louiscklaw/stm32_aux_keyboard/_ref/2019-06-02-14-12-keeb.io.png

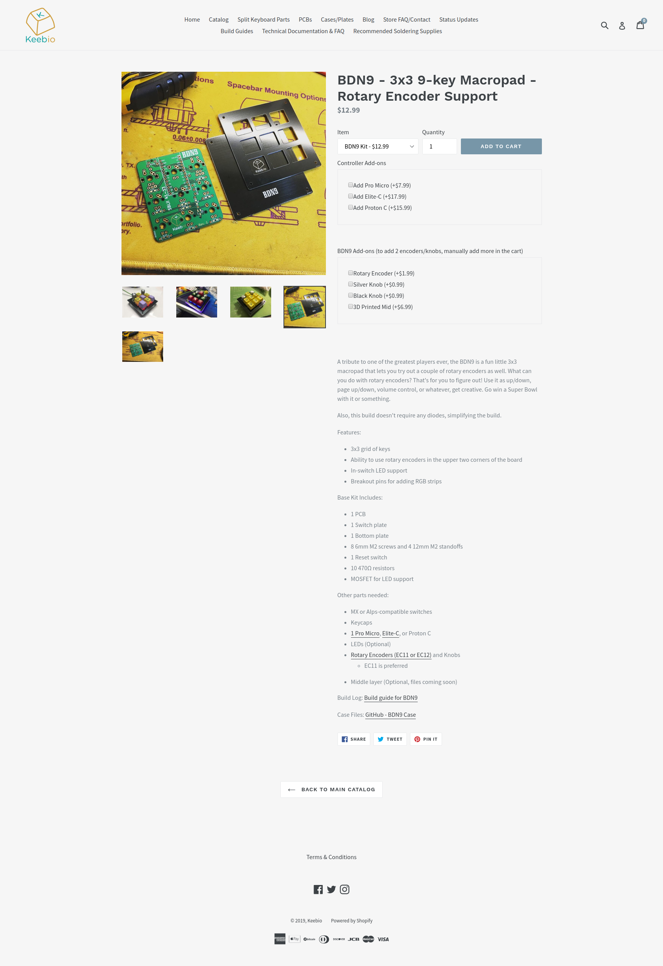
_ref/2019-06-02-14-12-keeb.io.png
