louiscklaw/stm32_aux_keyboard/_ref/TB24ozynljTBKNjSZFDXXbVgVXa_!!2891423389.jpg

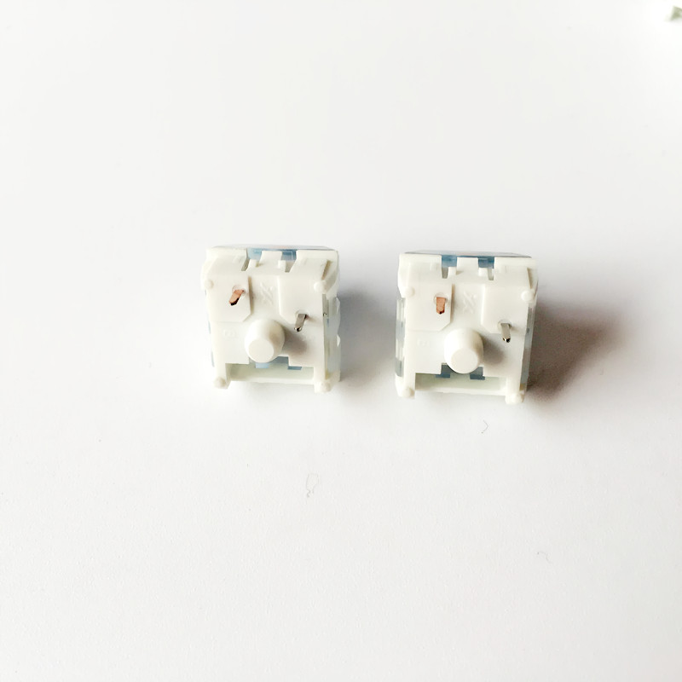
_ref/TB24ozynljTBKNjSZFDXXbVgVXa_!!2891423389.jpg
