louiscklaw/stm32_aux_keyboard/datasheet/MLT-8530.jpg

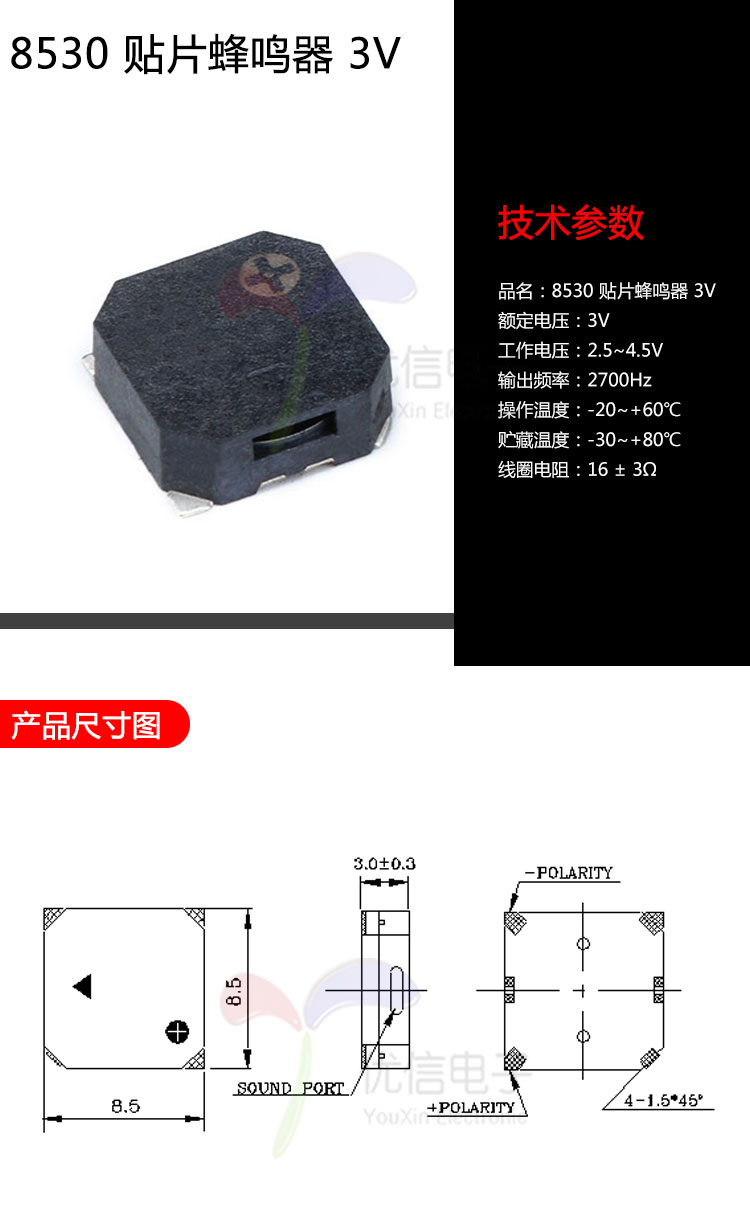
datasheet/MLT-8530.jpg
