louiscklaw/stm32_aux_keyboard/_models/crkbd-master/corne-classic/acrylic_plate/tilting-tenting.dxf

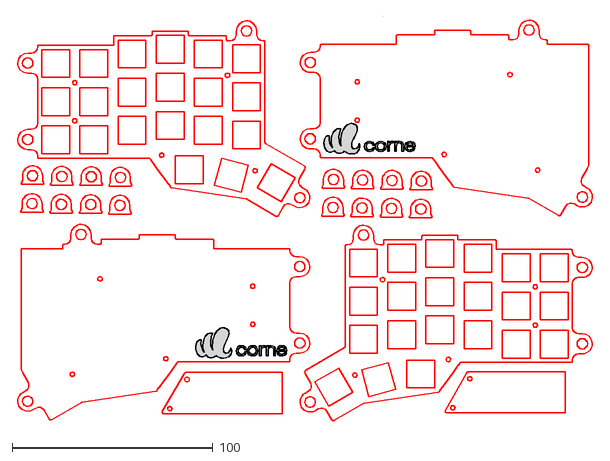
[picture p4: CAD file, 2019-06-02]
_models/crkbd-master/corne-classic/acrylic_plate/tilting-tenting.dxf
287.5 x 201.4
