louiscklaw/stm32_aux_keyboard/_models/crkbd-master/corne-jian/caps/corne-cap.FCStd

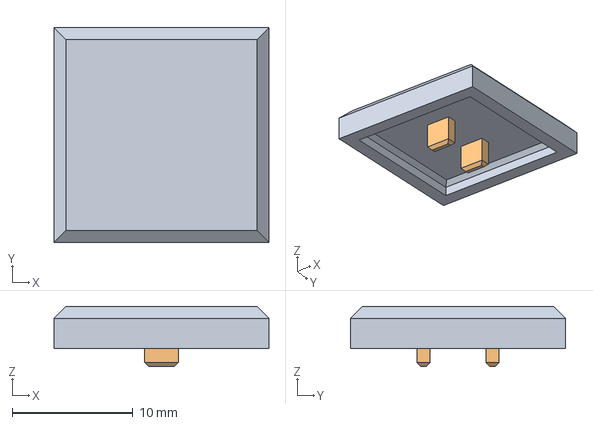
[picture p5: CAD file, 2019-06-02]
_models/crkbd-master/corne-jian/caps/corne-cap.FCStd
17.8 x 17.8 x 5.00 mm
