louiscklaw/stm32_aux_keyboard/_models/crkbd-master/corne-jian/case/corne-case-mirror.stl

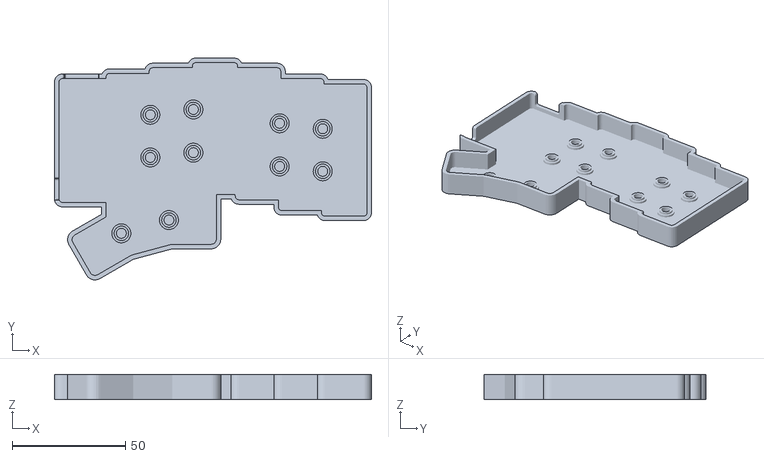
[picture p6: CAD file, 2019-06-02]
_models/crkbd-master/corne-jian/case/corne-case-mirror.stl
139.8 x 97.8 x 11.1
