louiscklaw/stm32_aux_keyboard/_models/crkbd-master/corne-jian/pcb/3d-models/kailh-choc-switch-cap-custom.step

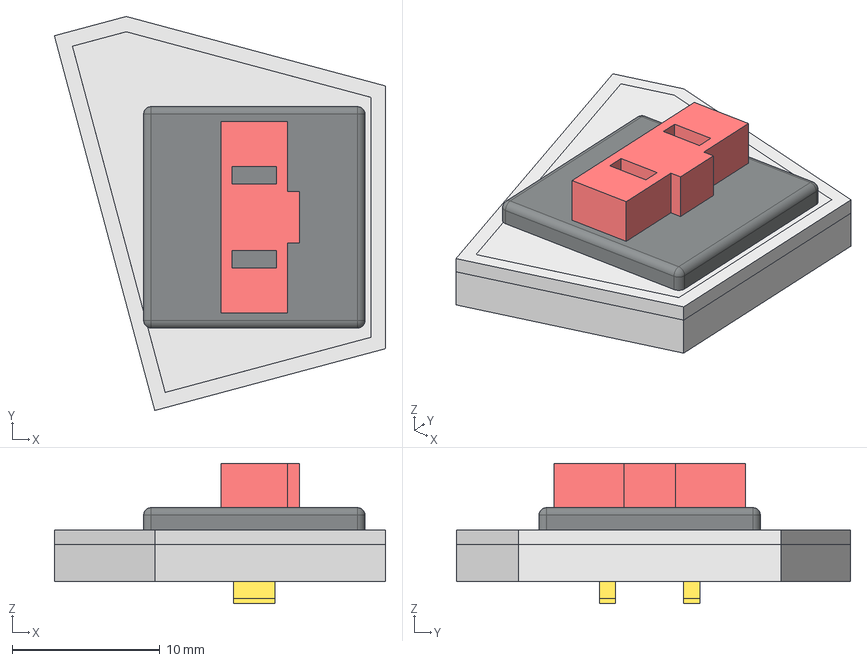
[picture p7: CAD file, 2019-06-02]
_models/crkbd-master/corne-jian/pcb/3d-models/kailh-choc-switch-cap-custom.step
22.5 x 26.7 x 9.50 mm
ShapeBinder001 x 2
Offset2D
Sketch005
