louiscklaw/stm32_aux_keyboard/casing/Extrude.step

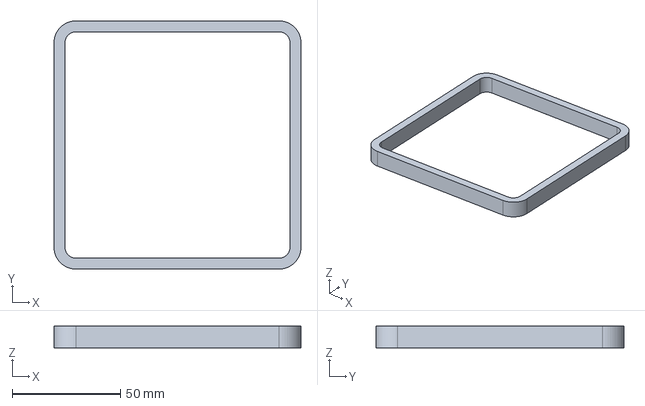
[picture p9: CAD file, 2019-06-04]
casing/Extrude.step
114.2 x 114.8 x 10.0 mm
