louiscklaw/stm32_aux_keyboard/_models/crkbd-master/corne-classic/acrylic_plate/top-bottom.dxf

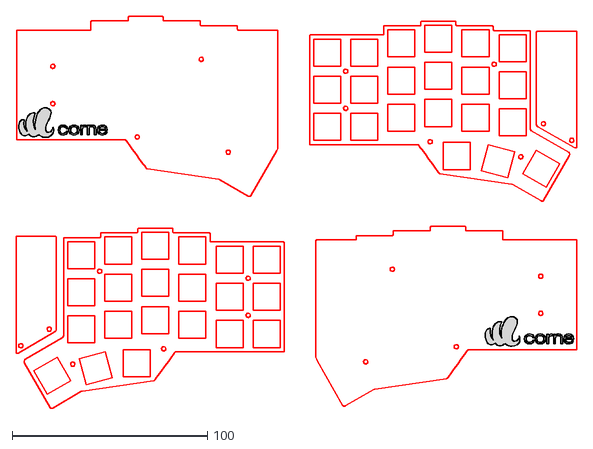
[picture p10: CAD file, 2019-06-02]
_models/crkbd-master/corne-classic/acrylic_plate/top-bottom.dxf
287.2 x 200.8
