louiscklaw/stm32_aux_keyboard/_models/crkbd-master/corne-jian/caps/corne-cap-custom-mirror.stl

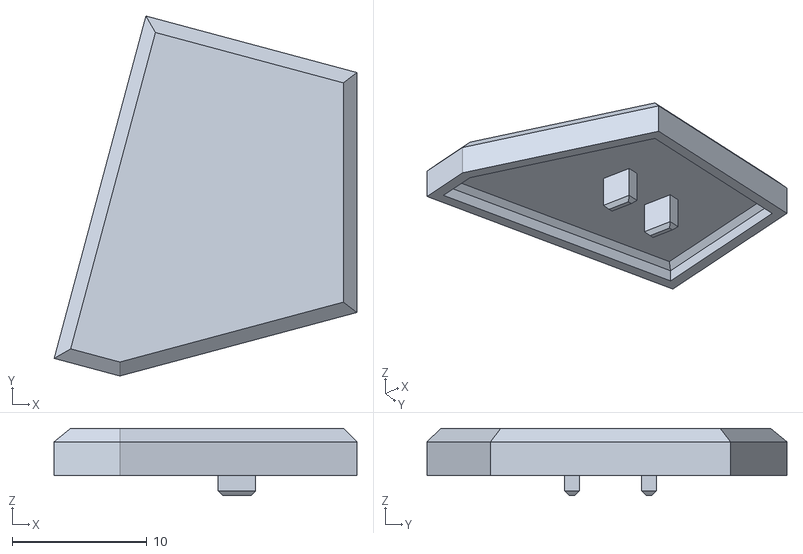
[picture p11: CAD file, 2019-06-02]
_models/crkbd-master/corne-jian/caps/corne-cap-custom-mirror.stl
22.5 x 26.7 x 5.00
