louiscklaw/stm32_aux_keyboard/_models/crkbd-master/corne-jian/pcb/3d-models/kailh-choc-switch.step

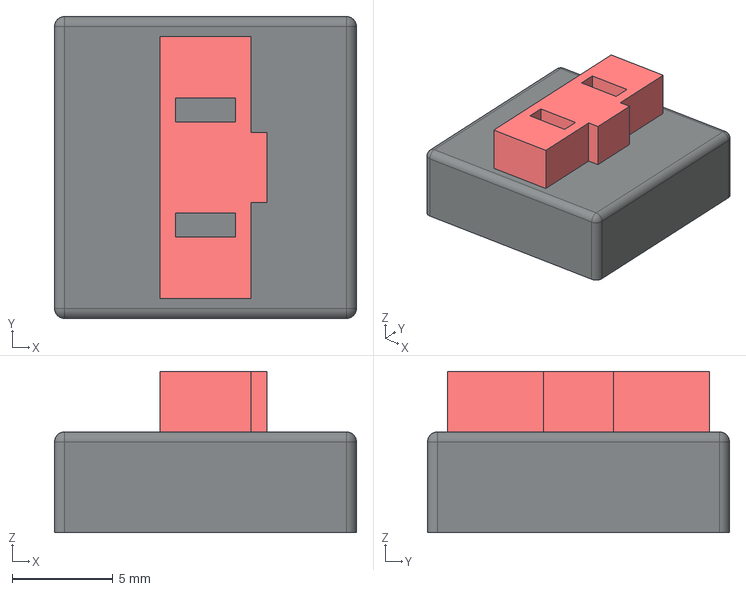
[picture p12: CAD file, 2019-06-02]
_models/crkbd-master/corne-jian/pcb/3d-models/kailh-choc-switch.step
15.0 x 15.0 x 8.00 mm
Stem
