louiscklaw/stm32_aux_keyboard/_models/MX 轴标准键帽.STEP

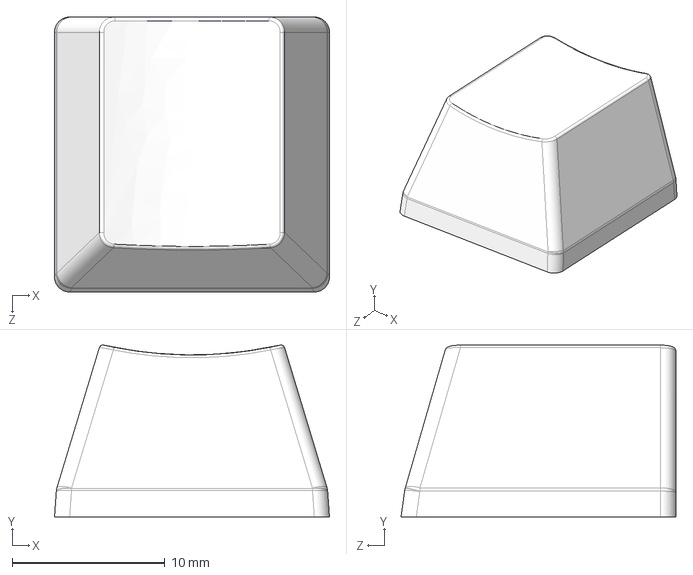
[picture p13: CAD file, 2019-06-02]
_models/MX 轴标准键帽.STEP
18.0 x 11.3 x 18.0 mm
