louiscklaw/stm32_aux_keyboard/_models/crkbd-master/corne-jian/pcb/3d-models/kailh-choc-switch-cap.step

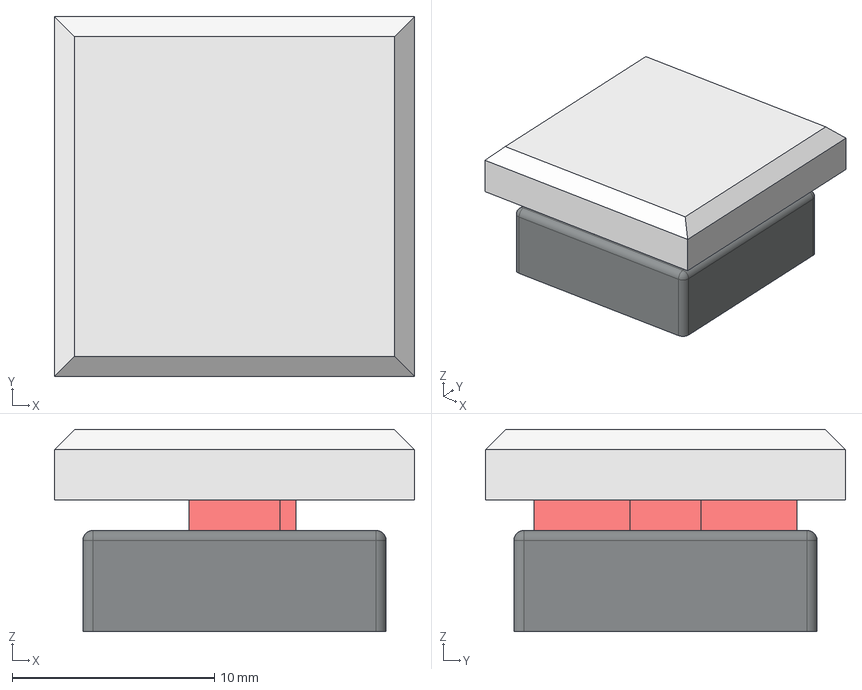
[picture p14: CAD file, 2019-06-02]
_models/crkbd-master/corne-jian/pcb/3d-models/kailh-choc-switch-cap.step
17.8 x 17.8 x 10.0 mm
Stem
ShapeBinder x 2
