louiscklaw/stm32_aux_keyboard/(list of files, cad)

Other CAD files:
_models/crkbd-master/corne-jian/case/corne-case.stl
casing/Cube.step
_models/crkbd-master/corne-jian/caps/corne-cap-custom.stl
casing/casing.FCStd
_models/crkbd-master/corne-jian/caps/corne-cap.stl
