louiscklaw/stm32_aux_keyboard/(list of files, drawings)

Other design files:
hardware/buzzer.dsn
hardware/keyboard_key.dsn
hardware/oled.dsn
hardware/power.dsn
hardware/rot_enc2.dsn
hardware/rot_enc.dsn
hardware/stm32_aux_keyboard.dsn
hardware/stm32_core.dsn
hardware/stm32_swd.dsn
