louiscklaw/stm32_aux_keyboard/hardware/stm32_aux_keyboard.kicad_pcb

## KiCad design hardware/stm32_aux_keyboard.kicad_pcb (2019-06-06)

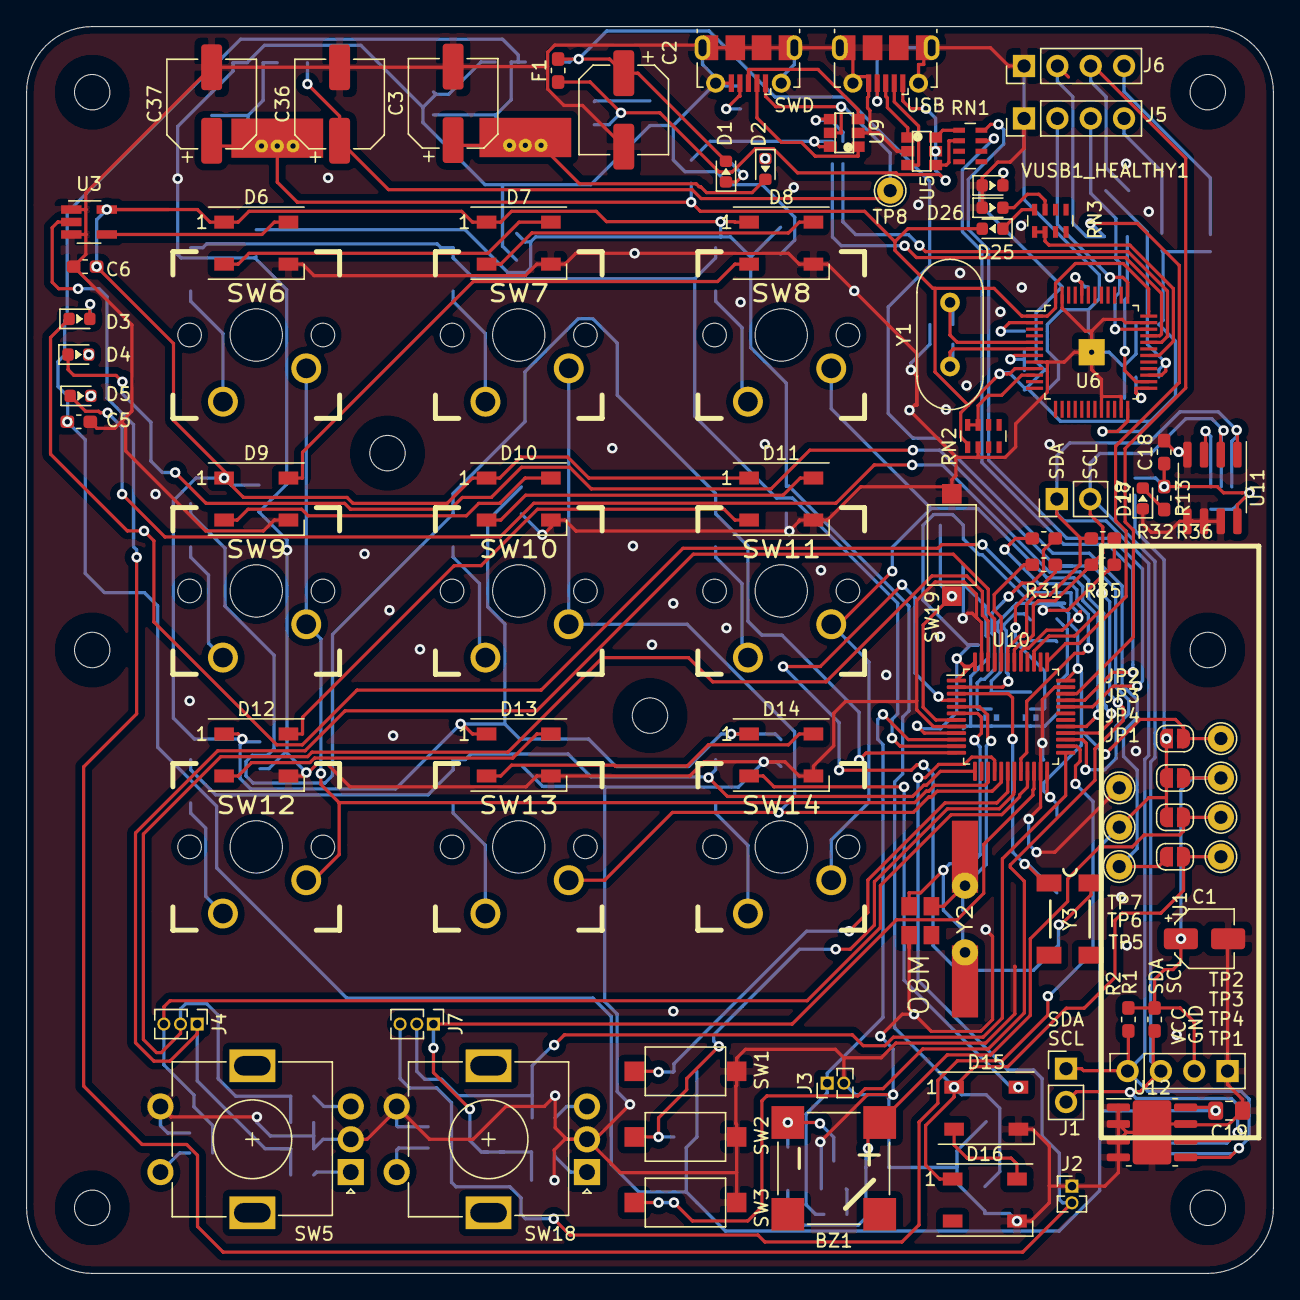
[picture p15: board stm32_aux_keyboard.kicad_pcb from above]

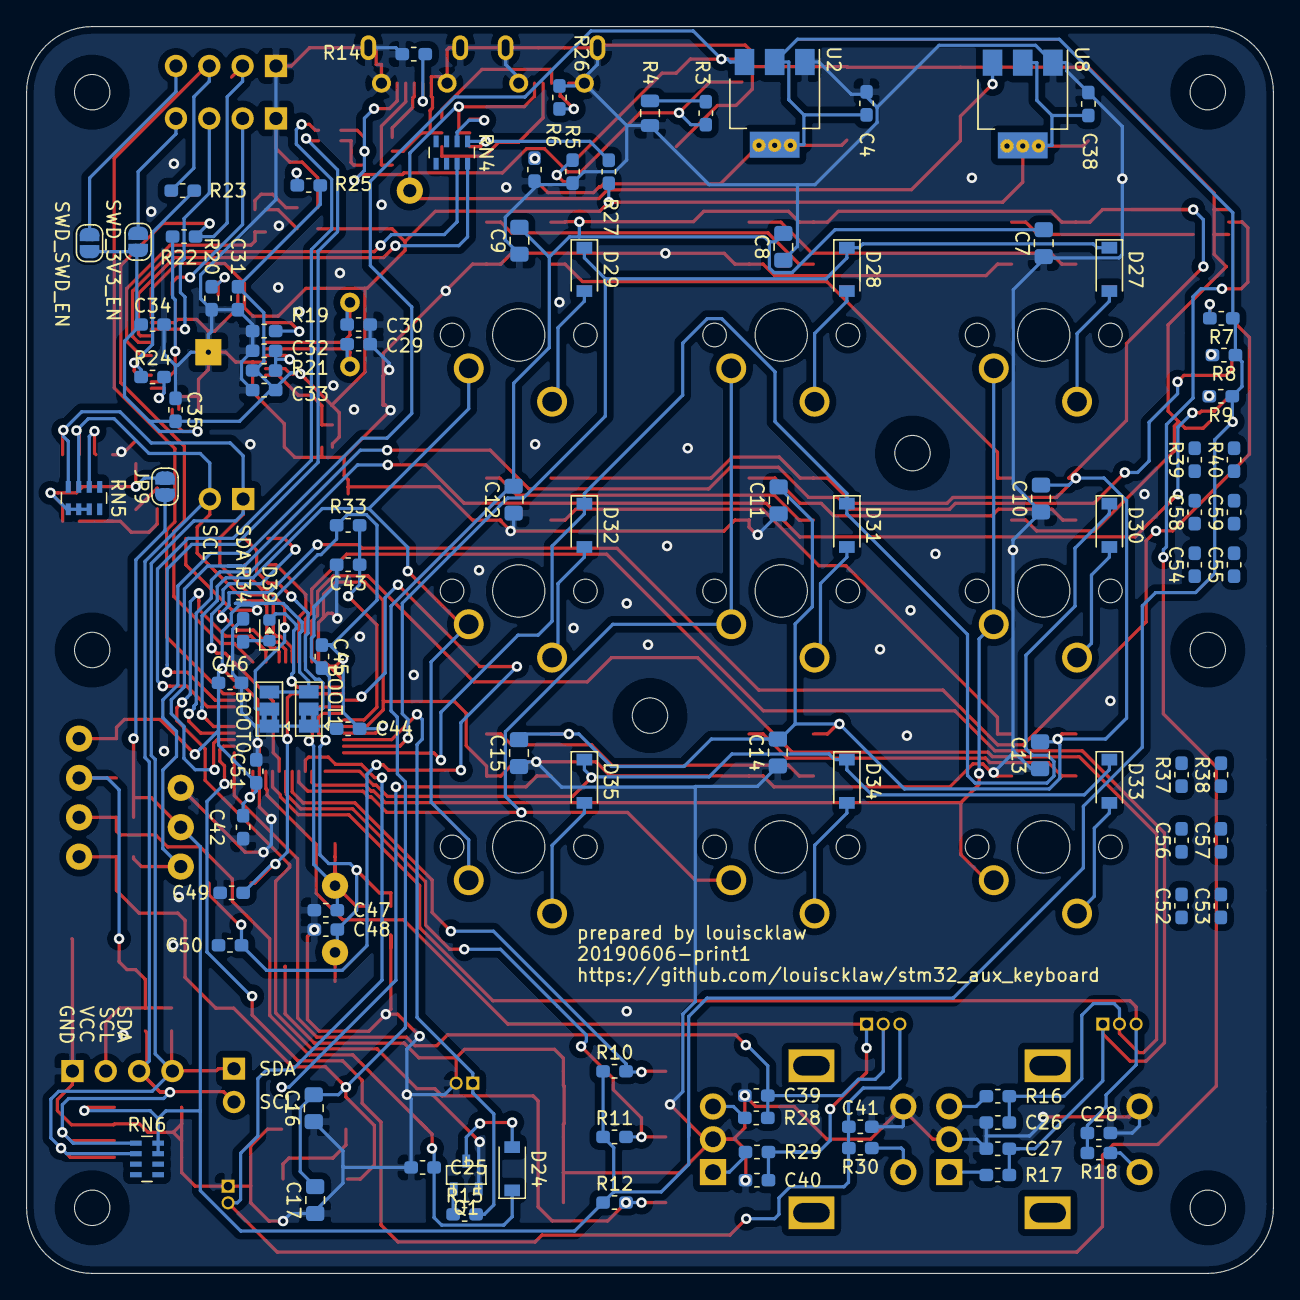
[picture p16: board stm32_aux_keyboard.kicad_pcb from below]

Board: 2 copper layers, 95.0 x 95.0 mm, 197 parts (100 on the bottom side), 113 nets.

Parts:
BZ1: BUZZER,MLT-8530; MLT-8530
C1: CP10uf,16V; CP_Elec_4x5.3
C2, C3, C36, C37: CP100uf,16V; CP_Elec_6.3x5.3
C4, C38: C105; C_0603_1608Metric_Pad1.05x0.95mm_HandSolder
C5, C6, C25: C106,0603; C_0603_1608Metric_Pad1.05x0.95mm_HandSolder
C7, C8, C9, C10, C11, C12, C13, C14, C15, C16, C17, C19: C106,0805; C_0805_2012Metric_Pad1.15x1.40mm_HandSolder
C18: C103,0603; C_0603_1608Metric_Pad1.05x0.95mm_HandSolder
C26, C27, C28, C31, C32, C33, C34, C35, C39, C40, C41, C42, C44, C45, C46, C51: C104,0603; C_0603_1608Metric_Pad1.05x0.95mm_HandSolder
C29, C30: C20pf,0603; C_0603_1608Metric_Pad1.05x0.95mm_HandSolder
C43: C105,0603; C_0603_1608Metric_Pad1.05x0.95mm_HandSolder
C47, C48, C49, C50: C20pf; C_0603_1608Metric_Pad1.05x0.95mm_HandSolder
C52, C53, C54, C55, C56, C57, C58, C59: SPARE,0603; C_0603_1608Metric_Pad1.05x0.95mm_HandSolder
D1: LED_GREEN; LED_0603_1608Metric
D2: LED_ORANGE; LED_0603_1608Metric
D3: USR_LED_1; LED_0603_1608Metric
D4: USR_LED_2; LED_0603_1608Metric
D5: USR_LED_3; LED_0603_1608Metric
D6, D7, D8, D9, D10, D11, D12, D13, D14, D15, D16: WS2812B; LED_WS2812B_5050_white
D17, D25: LED_GREEN,0603; LED_0603_1608Metric
D24, D27, D28, D29, D30, D31, D32, D33, D34, D35: D_1N4148_T4; D_SOD-123
D26: LED_RED,0603; LED_0603_1608Metric
D39: PC13; LED_0603_1608Metric
F1: Fuse_Small; R_0603_1608Metric_Pad1.05x0.95mm_HandSolder
H1, H2, H3, H4, H5, H6, H7, H8: MOUNT_M2; MountingHole_2.7mm_M2.5,rpi_like
J1, J8: I2C_HEADER,2.54; I2C_DEBUG,2.54
J2: WS2812_HEADER; PinHeader_1x02_P1.27mm_Vertical
J3: BUZZER_HEADER; PinHeader_1x02_P1.27mm_Vertical
J4, J7: ROT_ENC_HEADER; PinHeader_1x03_P1.27mm_Vertical
J5, J6: SWD_SWD; BLUEPILL_SWD
JP1: WS2812_EN; SolderJumper-2_P1.3mm_Open_RoundedPad1.0x1.5mm
JP2: STM32_EN; SolderJumper-2_P1.3mm_Open_RoundedPad1.0x1.5mm
JP3: OLED_EN; SolderJumper-2_P1.3mm_Open_RoundedPad1.0x1.5mm
JP4: BUZZER_EN; SolderJumper-2_P1.3mm_Open_RoundedPad1.0x1.5mm
JP5: SWD_3V3_EN; SolderJumper-2_P1.3mm_Open_RoundedPad1.0x1.5mm
JP6: SWD_SWD_EN; SolderJumper-2_P1.3mm_Open_RoundedPad1.0x1.5mm
JP7: BOOT0; SolderJumper-3_P1.3mm_Bridged2Bar12_Pad1.0x1.5mm
JP8: BOOT1; SolderJumper-3_P1.3mm_Bridged2Bar12_Pad1.0x1.5mm
JP9: EN; SolderJumper-2_P1.3mm_Open_RoundedPad1.0x1.5mm
Q1: SS9013_J3; 9013,J3,SOT23
R1, R2, R35, R36: R472,0603; R_0603_1608Metric_Pad1.05x0.95mm_HandSolder
R3, R37, R38, R39, R40: R0,0603; R_0603_1608Metric_Pad1.05x0.95mm_HandSolder
R4: VAR_5V6,0805; VAR_0805
R5, R6, R34: R511,0603; R_0603_1608Metric_Pad1.05x0.95mm_HandSolder
R7, R8, R9, R10, R11, R12, R13, R33: R103,0603; R_0603_1608Metric_Pad1.05x0.95mm_HandSolder
R14, R19, R20, R21, R26: R104,0603; R_0603_1608Metric_Pad1.05x0.95mm_HandSolder
R15: R471,0603; R_0603_1608Metric_Pad1.05x0.95mm_HandSolder
R16, R17, R18, R28, R29, R30: R273,0603; R_0603_1608Metric_Pad1.05x0.95mm_HandSolder
R22, R23: R220,0603; R_0603_1608Metric_Pad1.05x0.95mm_HandSolder
R24: R101,0603; R_0603_1608Metric_Pad1.05x0.95mm_HandSolder
R25: R221,0603; R_0603_1608Metric_Pad1.05x0.95mm_HandSolder
R27: R152,0603; R_0603_1608Metric_Pad1.05x0.95mm_HandSolder
R31, R32: R104; R_0603_1608Metric_Pad1.05x0.95mm_HandSolder
RN1: RN_220,0603; R_Array_Concave_4x0603
RN2, RN5, RN6: RN_472,0603; R_Array_Concave_4x0603
RN3, RN4: RN_221,0603; R_Array_Concave_4x0603
SW1: USR_BTN_1; SW_SPST_CK_RS282G05A3
SW2: USR_BTN_2; SW_SPST_CK_RS282G05A3
SW3: USR_BTN_3; SW_SPST_CK_RS282G05A3
SW5: ROT2; RotaryEncoder_Alps_EC11E_Vertical_H20mm
SW6: KEY11; cherry_mx_without_led_100H
SW7: KEY12; cherry_mx_without_led_100H
SW8: KEY13; cherry_mx_without_led_100H
SW9: KEY21; cherry_mx_without_led_100H
SW10: KEY22; cherry_mx_without_led_100H
SW11: KEY23; cherry_mx_without_led_100H
SW12: KEY31; cherry_mx_without_led_100H
SW13: KEY32; cherry_mx_without_led_100H
SW14: KEY33; cherry_mx_without_led_100H
SW18: ROT1; RotaryEncoder_Alps_EC11E_Vertical_H20mm
SW19: SW_RESET,2_leg,SMD; SW_SPST_CK_RS282G05A3
TP1: TP_WS2812; TestPoint_THTPad_D2.0mm_Drill1.0mm
TP2: TP_STM32; TestPoint_THTPad_D2.0mm_Drill1.0mm
TP3: TP_OLED; TestPoint_THTPad_D2.0mm_Drill1.0mm
TP4: TP_BUZZER; TestPoint_THTPad_D2.0mm_Drill1.0mm
TP5: TP_5V; TestPoint_THTPad_D2.0mm_Drill1.0mm
TP6: TP_3V3; TestPoint_THTPad_D2.0mm_Drill1.0mm
TP7: TP_GND; TestPoint_THTPad_D2.0mm_Drill1.0mm
TP8: TP_VUSB1; TestPoint_THTPad_D2.0mm_Drill1.0mm
U1: SSD1306-OLED-I2C; SSD1306_OLED-0.91-128x32_4pin
U2, U8: AMS1117-3.3; AMS1117_SOT-223
U3: 74AHCT1G125; SOT-23-5_HandSoldering
U4: USB; USB_Micro-B_Molex-105017-0001
U5, U9: USBLC6-2SC6_SOT23-6
U6: STM32F103C8T6_rect; STM32F103C8T6
U7: SWD; USB_Micro-B_Molex-105017-0001
U10: STM32F103C8T6; LQFP-48_7x7mm_P0.5mm
U11: LM75; SOP-8_3.76x4.96mm_P1.27mm
U12: 24C02_SOIC8; 24Cxx_SOIC8
VUSB1_HEALTHY1: LED_GREEN,0603; LED_0603_1608Metric
Y1: O_8M; Crystal_HC49-4H_Vertical
Y2: O8M; osc_debug
Y3: O_EPSON_32.768K; MC-306

Connections:
+3V3: C3.1, C4.1, C5.1, C19.2, D2.2, JP2.2, JP3.2, JP4.2, JP9.1, R7.1, R8.1, R9.1, R10.1, R11.1, R12.1, RN6.7, RN6.8, TP6.1, U2.2, U12.8
+5V: C2.1, D1.2, F1.2, JP1.2, TP5.1, U2.3
/24cxx/SCL: J1.SCL, J8.SCL, R1.2, R35.1, RN5.3, RN6.1, U1.SCL, U10.42, U11.2, U12.6
/24cxx/SDA: J1.SDA, J8.SDA, R2.2, R36.1, RN5.4, RN6.2, U1.SDA, U10.43, U11.1, U12.5
/WS2812/WS2812_IN: J2.2, U3.2, U10.16
/keyboard_key/COL1: SW6.2, SW9.2, SW12.2, U10.15
/keyboard_key/COL2: SW7.2, SW10.2, SW13.2, U10.17
/keyboard_key/COL3: SW8.2, SW11.2, SW14.2, U10.29
/keyboard_key/ROW1: D27.1, D28.1, D29.1, U10.11
/keyboard_key/ROW2: D30.1, D31.1, D32.1, U10.12
/keyboard_key/ROW3: D33.1, D34.1, D35.1, U10.13
/rot_enc2/A: C27.1, J4.1, R17.2, U10.45
/rot_enc2/B: C26.1, J4.2, R16.2, U10.46
/rot_enc/A: C40.1, J7.1, R29.2, U10.22
/rot_enc/B: C39.1, J7.2, R28.2, U10.25
/status_display/USR_LED_1: D3.1, U10.41
/status_display/USR_LED_2: D4.1, U10.27
/status_display/USR_LED_3: D5.1, U10.28
/stm32_core/BOOT0: R31.2, U10.44
/stm32_core/BOOT1: R32.1, U10.20
/stm32_core/BUZZER: J3.1, R15.2, U10.10
/stm32_core/OSC32K_N: C50.1, U10.4, Y3.4
/stm32_core/OSC32K_P: C49.1, U10.3, Y3.1
/stm32_core/OSC_N: C48.1, U10.6, Y2.3
/stm32_core/OSC_P: C47.1, U10.5, Y2.1
/stm32_core/PC13: D39.2, U10.2
/stm32_core/RESET: C43.1, R33.2, SW19.2, U10.7
/stm32_core/ROT_ENC_SW1: C28.1, J4.3, R18.2, U10.21
/stm32_core/ROT_ENC_SW2: C41.1, J7.3, R30.2, U10.26
/stm32_core/USB_N: RN1.8, U10.32
/stm32_core/USB_P: RN1.7, U10.33
/stm32_core/USR_BTN1: R10.2, SW1.1, U10.18
/stm32_core/USR_BTN2: R11.2, SW2.1, U10.19
/stm32_core/USR_BTN3: R12.2, SW3.1, U10.39
/stm32_swd/D_SWCLK: J6.2, R22.1, U10.37
/stm32_swd/D_SWDIO: J6.3, R23.1, U10.34
/stm32_swd/LED_STLINK: RN3.1, RN3.2, U6.30
/stm32_swd/SWCLK: J5.2, U6.37
/stm32_swd/SWDIO: J5.3, U6.34
/stm32_swd/T_JTCK: R22.2, U6.26
/stm32_swd/T_JTMS: R23.2, R24.1, U6.27
/stm32_swd/USB_N: RN4.7, U6.32
/stm32_swd/USB_P: RN4.8, U6.33
GND: C1.2, C2.2, C3.2, C4.2, C5.2, C6.1, C7.1, C8.1, C9.1, C10.1, C11.1, C12.1, C13.1, C14.1, C15.1, C16.1, C17.1, C18.2, C19.1, C25.2, C26.2, C27.2, C28.2, C29.1, C30.1, C31.2, C32.2, C33.1, C34.2, C35.1, C36.2, C37.2, C38.2, C39.2, C40.2, C41.2, C42.2, C43.2, C44.2, C45.2, C46.2, C47.2, C48.2, C49.2, C50.2, C51.2, D6.3, D7.3, D8.3, D9.3, D10.3, D11.3, D12.3, D13.3, D14.3, D15.3, D16.3, D17.1, D26.1, J2.1, J3.2, J5.1, J6.1, JP7.1, JP8.1, Q1.2, R4.2, R5.2, R6.2, R14.2, R19.1, R20.1, R26.2, R34.2, RN2.2, SW1.2, SW2.2, SW3.2, SW5.C, SW5.E, SW18.C, SW18.E, SW19.1, TP7.1, U1.GND, U2.1, U3.1, U3.3, U4.5, U4.6, U4.7, U4.8, U4.9, U5.2, U6.8, U6.20, U6.23, U6.35, U6.47, U7.5, U7.6, U7.7, U7.8, U7.9, U8.1, U9.2, U10.8, U10.23, U10.35, U10.47, U11.4, U11.5, U11.6, U11.7, U12.1, U12.2, U12.3, U12.4, U12.7, VUSB1_HEALTHY1.1, Y2.2
unnamed: BZ1.N, D24.2, Q1.3
unnamed: C18.1, JP9.2, R13.1, RN5.5, RN5.6, RN5.7, U11.8
unnamed: C29.2, U6.6, Y1.1
unnamed: C30.2, U6.5, Y1.2
unnamed: C32.1, R21.2, U6.7
unnamed: D1.1, R5.1
unnamed: D2.1, R6.1
unnamed: D3.2, R7.2
unnamed: D4.2, R8.2
unnamed: D5.2, R9.2
unnamed: D6.2, D7.4
unnamed: D6.4, U3.4
unnamed: D7.2, D8.4
unnamed: D8.2, D9.4
unnamed: D10.2, D11.4
unnamed: D9.2, D10.4
unnamed: D11.2, D12.4
unnamed: D12.2, D13.4
unnamed: D13.2, D14.4
unnamed: D14.2, D15.4
unnamed: D15.2, D16.4
unnamed: D17.2, R13.2
unnamed: D25.1, RN3.8
unnamed: D26.2, RN3.7
unnamed: D27.2, SW6.1
unnamed: D28.2, SW7.1
unnamed: D29.2, SW8.1
unnamed: D30.2, SW9.1
unnamed: D31.2, SW10.1
unnamed: D32.2, SW11.1
unnamed: D33.2, SW12.1
unnamed: D34.2, SW13.1
unnamed: D35.2, SW14.1
unnamed: D39.1, R34.1
unnamed: J5.4, JP5.2
unnamed: J6.4, JP6.2
unnamed: RN5.2, U11.3
unnamed: JP7.2, R31.1
unnamed: JP8.2, R32.2
unnamed: Q1.1, R15.1
unnamed: R3.2, R4.1
unnamed: R14.1, U4.4
unnamed: R16.1, SW5.B
unnamed: R17.1, SW5.A
unnamed: R18.1, SW5.D
unnamed: R19.2, U6.2
unnamed: R20.2, U6.44
unnamed: R24.2, U6.25
unnamed: R25.1, VUSB1_HEALTHY1.2
unnamed: R26.1, U7.4
unnamed: R27.2, RN4.1, U9.6
unnamed: R28.1, SW18.B
unnamed: R29.1, SW18.A
unnamed: R30.1, SW18.D
unnamed: RN1.1, U5.6
unnamed: RN1.2, U5.4
unnamed: RN2.7, RN2.8, U6.10
unnamed: RN4.2, U9.4
unnamed: U4.2, U5.3
unnamed: U4.3, U5.1
unnamed: U7.2, U9.1
unnamed: U7.3, U9.3
VCC: C6.2, C7.2, C8.2, C9.2, C10.2, C11.2, C12.2, C13.2, C14.2, C15.2, C16.2, C17.2, D6.1, D7.1, D8.1, D9.1, D10.1, D11.1, D12.1, D13.1, D14.1, D15.1, D16.1, JP1.1, TP1.1, U3.5
Vbuzzer: BZ1.P, C25.1, D24.1, JP4.1, TP4.1
Voled: C1.1, JP3.1, R1.1, R2.1, TP3.1, U1.VCC
Vstm32: C42.1, C44.1, C45.1, C46.1, C51.1, JP2.1, JP7.3, JP8.3, R33.1, R35.2, R36.2, TP2.1, U10.1, U10.9, U10.24, U10.36, U10.48
Vstm32_stlink: C31.1, C33.2, C34.1, C35.2, C37.1, C38.1, D25.2, JP5.1, JP6.1, R21.1, R25.2, R27.1, RN2.1, U6.1, U6.9, U6.24, U6.36, U6.48, U8.2
Vusb: F1.1, R3.1, U4.1, U5.5
Vusb_1: C36.1, TP8.1, U7.1, U8.3, U9.5
