louiscklaw/stm32_aux_keyboard/hardware/power.kicad_pcb

## KiCad design hardware/power.kicad_pcb (2019-06-02)

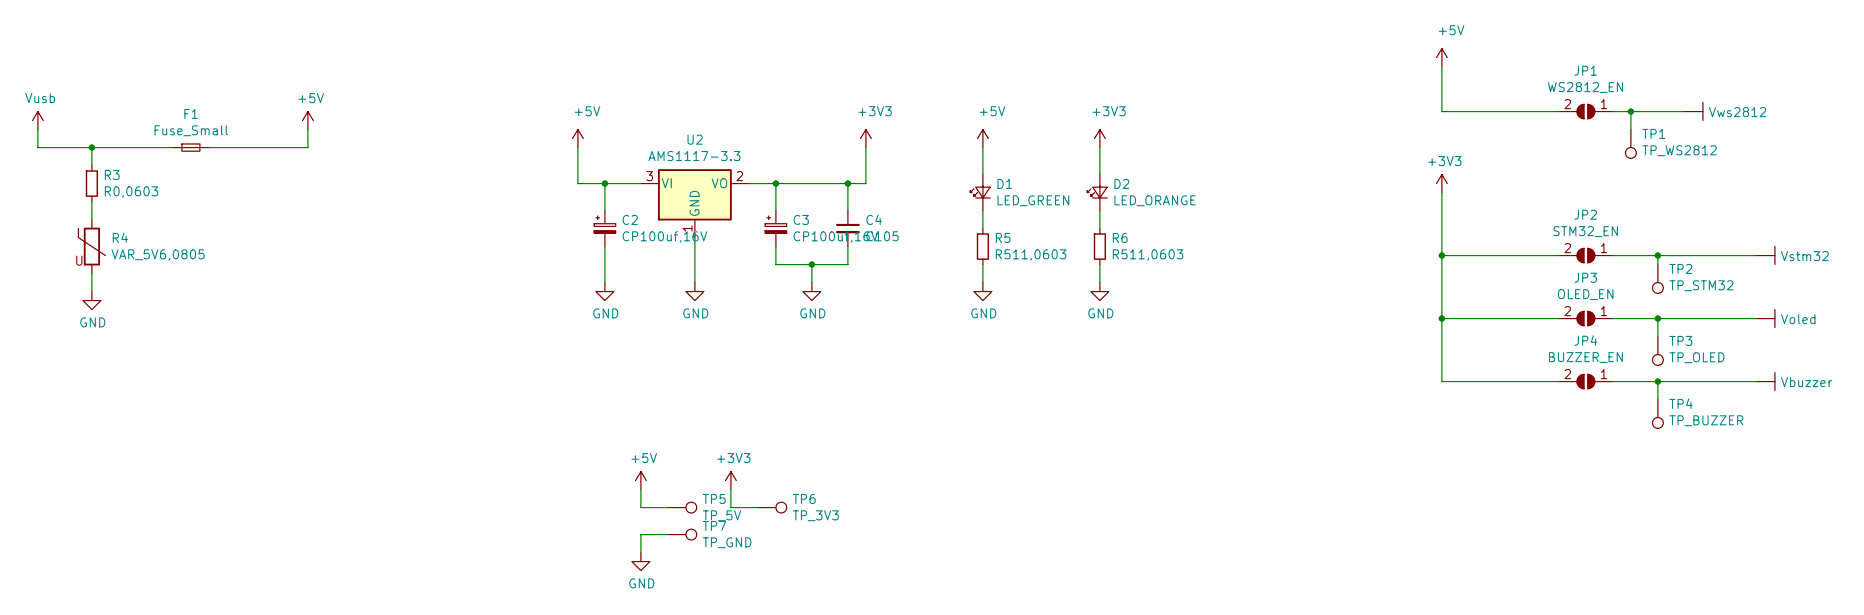
[picture p17: schematic power.sch]

Parts:
C2, C3: CP100uf,16V; CP_Elec_6.3x5.3
C4: C105; C_0603_1608Metric_Pad1.05x0.95mm_HandSolder
D1: LED_GREEN; LED_0603_1608Metric
D2: LED_ORANGE; LED_0603_1608Metric
F1: Fuse_Small; R_0603_1608Metric_Pad1.05x0.95mm_HandSolder
JP1: WS2812_EN; SolderJumper-2_P1.3mm_Open_RoundedPad1.0x1.5mm
JP2: STM32_EN; SolderJumper-2_P1.3mm_Open_RoundedPad1.0x1.5mm
JP3: OLED_EN; SolderJumper-2_P1.3mm_Open_RoundedPad1.0x1.5mm
JP4: BUZZER_EN; SolderJumper-2_P1.3mm_Open_RoundedPad1.0x1.5mm
R3: R0,0603; R_0603_1608Metric_Pad1.05x0.95mm_HandSolder
R4: VAR_5V6,0805; VAR_0805
R5, R6: R511,0603; R_0603_1608Metric_Pad1.05x0.95mm_HandSolder
TP1: TP_WS2812; TestPoint_THTPad_D2.0mm_Drill1.0mm
TP2: TP_STM32; TestPoint_THTPad_D2.0mm_Drill1.0mm
TP3: TP_OLED; TestPoint_THTPad_D2.0mm_Drill1.0mm
TP4: TP_BUZZER; TestPoint_THTPad_D2.0mm_Drill1.0mm
TP5: TP_5V; TestPoint_THTPad_D2.0mm_Drill1.0mm
TP6: TP_3V3; TestPoint_THTPad_D2.0mm_Drill1.0mm
TP7: TP_GND; TestPoint_THTPad_D2.0mm_Drill1.0mm
U2: AMS1117-3.3; AMS1117_SOT-223

Connections:
+3V3: C3.1, C4.1, D2.2 (A), JP2.2 (B), JP3.2 (B), JP4.2 (B), TP6.1, U2.2 (VO)
+5V: C2.1, D1.2 (A), F1.2, JP1.2 (B), TP5.1, U2.3 (VI)
GND: C2.2, C3.2, C4.2, R4.2, R5.2, R6.2, TP7.1, U2.1 (GND)
unnamed: D1.1 (K), R5.1
unnamed: D2.1 (K), R6.1
unnamed: R3.2, R4.1
Vbuzzer: JP4.1 (A), TP4.1
Voled: JP3.1 (A), TP3.1
Vstm32: JP2.1 (A), TP2.1
Vusb: F1.1, R3.1
Vws2812: JP1.1 (A), TP1.1

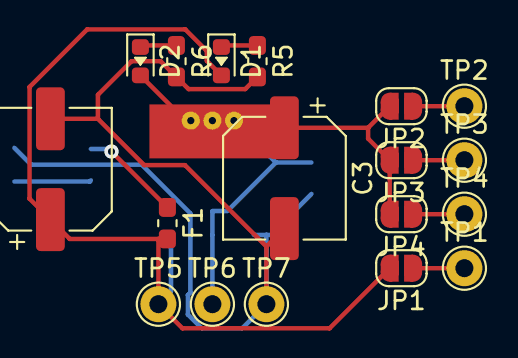
[picture p18: board power.kicad_pcb from above]

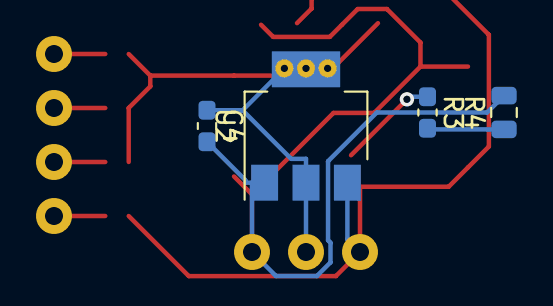
[picture p19: board power.kicad_pcb from below]

Board: 2 copper layers, 22 parts (4 on the bottom side), 11 nets.
