louiscklaw/stm32_aux_keyboard/hardware/oled.kicad_pcb

## KiCad design hardware/oled.kicad_pcb (2019-06-02)

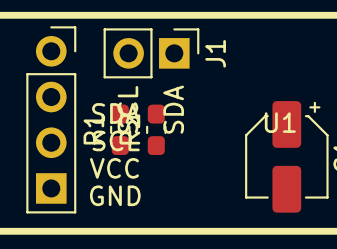
[picture p20: board oled.kicad_pcb from above]

Board: 2 copper layers, 5 parts (0 on the bottom side), 4 nets, no tracks yet.

Parts:
C1: CP10uf,16V; CP_Elec_4x5.3
J1: I2C_HEADER,2.54; I2C_DEBUG,2.54
R1, R2: R472,0603; R_0603_1608Metric_Pad1.05x0.95mm_HandSolder
U1: SSD1306-OLED-I2C; SSD1306_OLED-0.91-128x32_4pin

Connections:
/SCL: J1.SCL, R1.2, U1.SCL
/SDA: J1.SDA, R2.2, U1.SDA
GND: C1.2, U1.GND
Voled: C1.1, R1.1, R2.1, U1.VCC
