louiscklaw/stm32_aux_keyboard/hardware/buzzer.kicad_pcb

## KiCad design hardware/buzzer.kicad_pcb (2019-06-02)

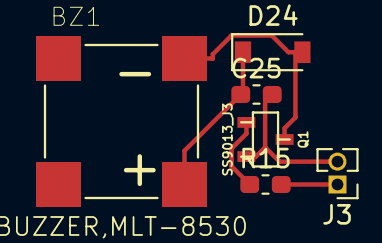
[picture p21: board buzzer.kicad_pcb from above]

Board: 2 copper layers, 6 parts (0 on the bottom side), 5 nets.

Parts:
BZ1: BUZZER,MLT-8530; MLT-8530
C25: C106,0603; C_0603_1608Metric_Pad1.05x0.95mm_HandSolder
D24: D_1N4148_T4; D_SOD-123
J3: BUZZER_HEADER; PinHeader_1x02_P1.27mm_Vertical
Q1: SS9013_J3; 9013,J3,SOT23
R15: R471,0603; R_0603_1608Metric_Pad1.05x0.95mm_HandSolder

Connections:
/BUZZER_IN: J3.1, R15.2
GND: C25.2, J3.2, Q1.2
unnamed: BZ1.N, D24.2, Q1.3
unnamed: Q1.1, R15.1
Vbuzzer: BZ1.P, C25.1, D24.1
