louiscklaw/stm32_aux_keyboard/(commit log)

2019-06-02 update for cherry key,
    [MX .STEP, MX 轴标准键帽.STEP, corne-bottom-plate.kicad_pcb, corne-cap-custom-mirror.stl, corne-cap-custom.stl, corne-cap.FCStd, corne-cap.stl, corne-case-mirror.stl]
2019-06-02 update for cherry key,wd
    [power.sch, rot_enc.sch, rot_enc2.sch, stm32_core.sch]
2019-06-02 update for power symbol,
    [WS2812.sch, buzzer.sch, oled.sch, power.sch, stm32_core.sch]
2019-06-02 update DRC ok,
    [stm32_aux_keyboard.sch]
2019-06-02 update point schedule,
    [stm32_point_schedule.ods]
2019-06-02 update footprint,
    [keyboard_key.sch, power.sch, stm32_core.sch, stm32_swd.sch, usb.sch]
2019-06-02 update pre-route,
    [status_display.sch]
2019-06-02 update route,
    [buzzer.dsn, buzzer.kicad_pcb, keyboard_key.dsn, keyboard_key.kicad_pcb, stm32_aux_keyboard.kicad_pcb]
2019-06-02 update rout,
    [stm32_core.dsn, stm32_core.kicad_pcb]
2019-06-02 update for routing,
    [power.dsn, power.kicad_pcb, stm32_aux_keyboard.dsn, stm32_aux_keyboard.kicad_pcb, stm32_core.sch]
2019-06-03 update ws2812,
    [stm32_aux_keyboard.kicad_pcb, stm32_core.dsn, stm32_core.kicad_pcb, stm32_core.sch, stm32_swd.dsn, stm32_swd.kicad_pcb]
2019-06-03 update remote btn4 and all capacitor in place,
    [keyboard_key.sch, push_buttton.sch, stm32_aux_keyboard.kicad_pcb]
2019-06-03 update for place complete,
    [stm32_aux_keyboard.kicad_pcb]
2019-06-03 update for add supporting hold,
    [stm32_aux_keyboard.dsn, stm32_aux_keyboard.kicad_pcb, stm32_aux_keyboard.sch]
2019-06-03 update labelling,
    [stm32_aux_keyboard.dsn, stm32_aux_keyboard.kicad_pcb]
2019-06-03 update model,
    [stm32_aux_keyboard.kicad_pcb]
2019-06-03 update DRC ok, no routing,
    [stm32_aux_keyboard.dsn, stm32_aux_keyboard.kicad_pcb]
2019-06-06 update for autoroute complete,
    [keyboard_key.kicad_pcb, stm32_aux_keyboard.dsn, stm32_aux_keyboard.kicad_pcb]
2019-06-06 update for tidy tracks,
    [stm32_aux_keyboard.kicad_pcb]
2019-06-06 check footprint,
    [stm32_aux_keyboard.kicad_pcb]
2019-06-06 send to fab,
    [stm32_aux_keyboard-B_Cu.gbr, stm32_aux_keyboard-B_Mask.gbr, stm32_aux_keyboard-B_Paste.gbr, stm32_aux_keyboard-B_SilkS.gbr, stm32_aux_keyboard-Edge_Cuts.gbr, stm32_aux_keyboard-F_Cu.gbr, stm32_aux_keyboard-F_Mask.gbr, stm32_aux_keyboard-F_Paste.gbr]
2019-06-06 prepare to fab,
    [stm32_aux_keyboard-B_Cu.gbr, stm32_aux_keyboard-B_Mask.gbr, stm32_aux_keyboard-B_Paste.gbr, stm32_aux_keyboard-B_SilkS.gbr, stm32_aux_keyboard-Edge_Cuts.gbr, stm32_aux_keyboard-F_Cu.gbr, stm32_aux_keyboard-F_Mask.gbr, stm32_aux_keyboard-F_Paste.gbr]
